mc-hamster/JMPM/hardware/README.md

Hardware Revisions.

JMPM 001

  Known issues:
  
    Ground Plane Isolate is 24mil. Next version should use 16mil.
