mc-hamster/JMPM/hardware/JMPM 001/README.md

Sent to JLC PCB on May 7, 2020

Distributor part numbers for LCSC are included as an attribute on every component.
