mc-hamster/JMPM/hardware/JMPM 001/JMPM 001.brd

## EAGLE design hardware/JMPM 001/JMPM 001.brd (2020-05-08)

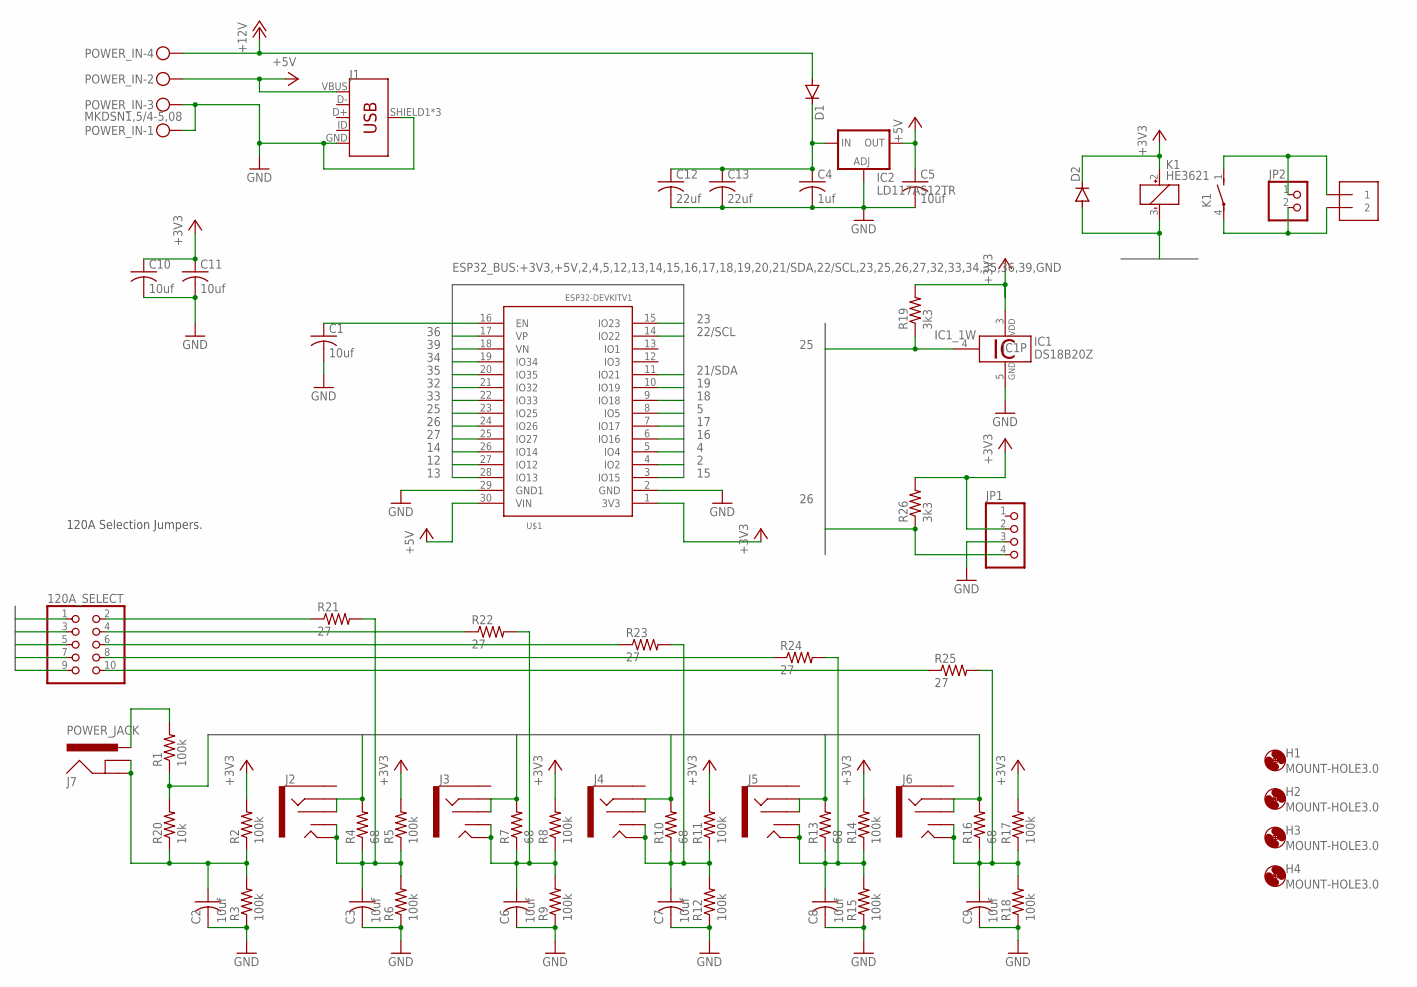
[picture p1: schematic JMPM 001.sch]

Parts:
120A_SELECT: PINHD-2X5; 2X05
C1, C2, C3, C5, C6, C7, C8, C9, C10, C11: 10uf; C0603; LCSC_PART_NUMBER C19702
C4: 1uf; C0603; LCSC_PART_NUMBER C15849
C12, C13: 22uf; C0805; LCSC_PART_NUMBER C45783
D1, D2: DIODE-DO-214AC; DO-214AC; LCSC_PART_NUMBER C95872
H1, H2, H3, H4: MOUNT-HOLE3.0; 3,0
IC1: DS18B20Z; SO08; LCSC_PART_NUMBER C97190
IC2: LD117AS12TR; SOT223; LCSC_PART_NUMBER C6187
J1: USB_MICRO-BREDUCED_PASTE; USB-B-MICRO-SMD_RED_PASTE
J2, J3, J4, J5, J6: AUDIO_JACK_3.5MM_KIT; AUDIO-JACK-KIT
J7: POWER_JACK; POWER_JACK_PTH
JP1: PINHD-1X4/90; 1X04/90
JP2: PINHD-1X2; 1X02
JP2B: 1X2-3.5MM; MPN OSTTE020161
K1: HE3621; MPN HE3621A0510
POWER_IN: MKDSN1,5/4-5,08
R1, R2, R3, R5, R6, R8, R9, R11, R12, R14, R15, R17, R18: 100k; R0603; LCSC_PART_NUMBER C25803
R4, R7, R10, R13, R16: 68; R0603; LCSC_PART_NUMBER C27592
R19, R26: 3k3; R0603; LCSC_PART_NUMBER C22978
R20: 10k; R0603; LCSC_PART_NUMBER C25804
R21, R22, R23, R24, R25: 27; R0603; LCSC_PART_NUMBER C25190
U$1: ESP32DEVKITV1; ESP32-DEVKITV1

Connections:
2: U$1.4 (IO2)
4: U$1.5 (IO4)
5: U$1.8 (IO5)
12: U$1.27 (IO12)
13: U$1.28 (IO13)
14: U$1.26 (IO14)
15: U$1.3 (IO15)
16: U$1.6 (IO16)
17: U$1.7 (IO17)
18: U$1.9 (IO18)
19: U$1.10 (IO19)
21/SDA: U$1.11 (IO21)
22/SCL: U$1.14 (IO22)
23: U$1.15 (IO23)
25: IC1.4 (1W), R19.1, U$1.23 (IO25)
26: JP1.4, R26.1, U$1.24 (IO26)
27: D2.A, K1.3 (-), U$1.25 (IO27)
32: 120A_SELECT.7, J5.RING, J5.RSH, R13.2, U$1.21 (IO32)
33: 120A_SELECT.9, J6.RING, J6.RSH, R16.2, U$1.22 (IO33)
34: 120A_SELECT.3, J3.RING, J3.RSH, R7.2, U$1.19 (IO34)
35: 120A_SELECT.5, J4.RING, J4.RSH, R10.2, U$1.20 (IO35)
36: R1.1, R20.2, U$1.17 (VP)
39: 120A_SELECT.1, J2.RING, J2.RSH, R4.2, U$1.18 (VN)
+3V3: C10.1, C11.1, D2.C, IC1.3 (VDD), JP1.2, K1.2 (+), R2.2, R5.2, R8.2, R11.2, R14.2, R17.2, R19.2, R26.2, U$1.1 (3V3)
+5V: C5.1, IC2.4 (OUT), J1.VBUS, POWER_IN.2, U$1.30 (VIN)
+12V: D1.A, POWER_IN.4
GND: C1.2, C2.2, C3.2, C4.2, C5.2, C6.2, C7.2, C8.2, C9.2, C10.2, C11.2, C12.2, C13.2, IC1.5 (GND), IC2.1 (ADJ), J1.GND, J1.SHIELD1 (SHIELD), J1.SHIELD2 (SHIELD), J1.SHIELD3 (SHIELD), JP1.3, POWER_IN.1, POWER_IN.3, R3.1, R6.1, R9.1, R12.1, R15.1, R18.1, U$1.2 (GND), U$1.29 (GND1)
unnamed: C1.1, U$1.16 (EN)
unnamed: C4.1, C12.1, C13.1, D1.C, IC2.3 (IN)
unnamed: J7.PWR, R1.2
unnamed: JP2.1, JP2B.1, K1.1 (S)
unnamed: 120A_SELECT.2, R21.1
unnamed: C2.1, J7.GND, J7.GNDBREAK, R2.1, R3.2, R20.1
unnamed: 120A_SELECT.4, R22.1
unnamed: C6.1, J3.TIP, J3.TSH, R7.1, R8.1, R9.2, R22.2
unnamed: 120A_SELECT.6, R23.1
unnamed: C7.1, J4.TIP, J4.TSH, R10.1, R11.1, R12.2, R23.2
unnamed: 120A_SELECT.8, R24.1
unnamed: C8.1, J5.TIP, J5.TSH, R13.1, R14.1, R15.2, R24.2
unnamed: 120A_SELECT.10, R25.1
unnamed: C9.1, J6.TIP, J6.TSH, R16.1, R17.1, R18.2, R25.2
unnamed: C3.1, J2.TIP, J2.TSH, R4.1, R5.1, R6.2, R21.2
unnamed: JP2.2, JP2B.2, K1.4

Notes on the sheet:
120A Selection Jumpers.

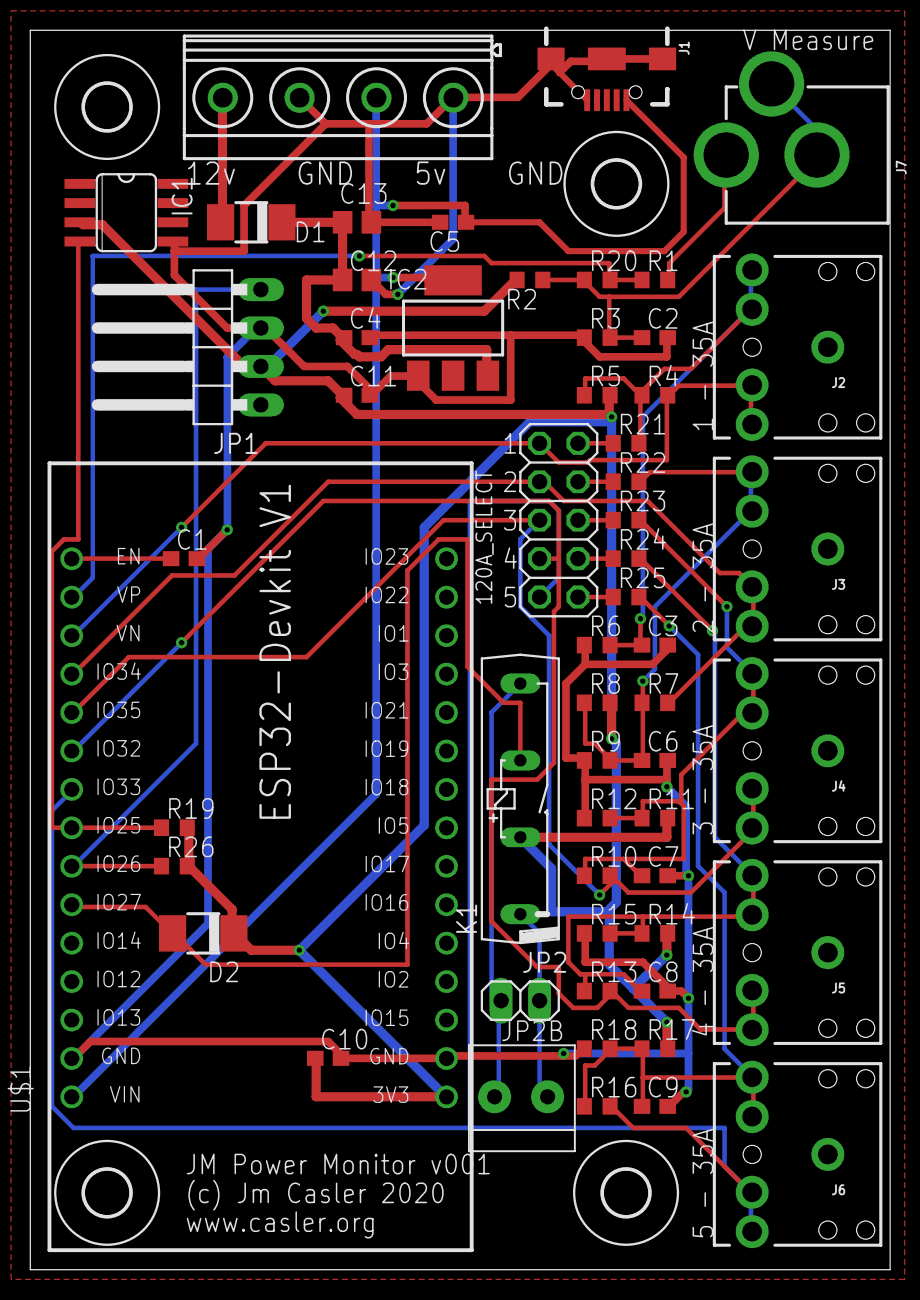
[picture p2: board JMPM 001.brd from above]

Board: 2 copper layers, 56.8 x 81.9 mm, 61 parts (0 on the bottom side), 29 nets.
